calderdigihub/PiWars21_crashBot/(commit log)

2021-06-03 Initial addition of example crashbot code and readme file within /mtvbot
    [crashbot_test.py]
2021-06-11 Updated controller model. Working with controller and actually going the correct way now
    [controller.py]
2021-06-18 adding first version for line sensors
